surfer-rfid/PCB/README.md

# PCB
PCB schematics, layout, BOM, and other data required to generate the S.U.R.F.E.R. PCB.
Note that one will see "rfidr" in many places in the source code. This is short
for "RFID reader", before S.U.R.F.E.R. had a unique name.
