surfer-rfid/PCB/BOM/RFIDr_Open_BOM.xls

Id | Designator | Package | Unit Quantity | 5x Build Quantity | Ordering Quantity | Designation | Rating | Tolerance | Supplier | Supplier P/N (CT/BU) | Manufacturer | Manuf. P/N | Price 1x | PriceBulk | PriceBreak | ReplLevel | Description | Notes
1 | R95,R94,R72,R75,R90,R88,R86,R7,R8,R17,R20,R21,R27,R28,R29,R36,R41,R44,R45,R47,R50,R58,R64,R69,R70,R73,R76,R77,R80,R82 | R_0402 | 30 | 150 | 200 | 0 | 1/16W | Jumper | Digikey | RMCF0402ZT0R00CT-ND | Stackpole Electronics, Inc | RMCF0402ZT0R00 | 0.1 | 0.00132 | 10000 | 0 | RES SMD 0.0 OHM JUMPER 1/16W
2 | R65,R71,R57,R74 | R_0402 | 0 | 0 | 0 | DNI
3 | U45,U47 | SC-70-5 | 2 | 10 | 20 | SN74LV1T34 | N/A | N/A | Digikey | 296-37177-1-ND | Texas Instruments | SN74LV1T34DCKR | 0.48 | 0.15 | 1000 | 1 | IC BUFFER GATE SGL CMOS SC-70-5
4 | C130,C131,C101,C123,C122,C121,C120,C108,C119,C110,C109,C116,C117,C118,C1,C2,C3,C4,C7,C8,C9,C15,C16,C17,C19,C26,C27,C29,C31,C34,C36,C38,C39,C40,C41,C42,C46,C47,C49,C50,C62,C89,C90,C92,C103 | C_0402 | 47 | 235 | 300 | 100n | 10V | 10.00% | Digikey | 490-7998-1-ND | Murata Electronics N.A. | GCM155R71C104KA55J | 0.1 | 0.0082 | 10000 | 0 | CAP CER 0.1UF 16V 10% X7R 0402
5 | C134,C111,C95,C44,C48,C55,C56,C85,C91,C105 | C_0402 | 10 | 50 | 100 | 1u | 16V | 10.00% | Digikey | 445-13181-1-ND | Samsung Electro-Mechanics | CGB2A1X5R1C105K033BC | 0.1 | 0.03542 | 5000 | 0 | CAR CER 1UF 16V 10% X5R 0402
6 | C135,C69,C70,C73 | C_0402 | 4 | 20 | 100 | 10n | 25V | 10.00% | Digikey | 490-6341-1-ND | Murata Electronics N.A. | GRM155R71E103KA01J | 0.1 | 0.00275 | 10000 | 0 | CAP CER 10000PF 25V 10% X7R 0402
7 | C132,C51,C52,C133,C45,C43 | C_0805 | 6 | 30 | 100 | 4.7u | 16V | 10.00% | Digikey | 490-7215-1-ND | Murata Electronics N.A. | GRM21BR61C475KA88K | 0.22 | 0.024 | 10000 | 0 | CAP CER 4.7UF 16V 10% X5R 0805
8 | U44 | MBR0520LTR | 1 | 5 | 10 | MBR0520LTR | 20V | N/A | Digikey | MBR0520LCT-ND | ON Semiconductor | MBR0520L | 0.39 | 0.0766 | 1000 | 0 | DIODE SCHOTTKY 20V 500MA SOD123
9 | U43 | SOT-23-5 | 1 | 5 | 10 | LM2767M5 | N/A | N/A | Digikey | LM2767M5/NOPBCT-ND | Texas Instruments | LM2767M5/NOPB | 0.92 | 0.031 | 15000 | 0 | IC REG SWITCHD CAP 2VIN SOT23
10 | U46 | SOT-23-5 | 1 | 5 | 10 | LP3985IM5-5.0 | N/A | N/A | Digikey | LP3985IM5-5.0/NOPBCT-ND | Texas Instruments | LP3985IM5-5.0/NOPB | 0.66 | 0.23 | 5000 | 0 | IC REG LINEAR 5V 150MA SOT23-5
11 | U15,U17,U16 | SOT-89-5 | 3 | 15 | 30 | AP7361C-Y5-13 | N/A | N/A | Digikey | AP7361C-Y5-13DICT-ND | Diodes Incorporated | AP7361C-Y5-13 | 0.65 | 0.19 | 25000 | 1 | IC REG LINEAR POS ADJ 1A SOT89-5
12 | D3,D9,D10 | R_0402 | 3 | 15 | 100 | XGD10402KR | 24V | N/A | Digikey | F6924CT-ND | Littelfuse Inc. | XGD10402KR | 0.52 | 0.12284 | 5000 | 0 | TVS DIODE 24VWM 40VC 0402
13 | C129,C128 | C_0201 | 2 | 10 | 150 | 22p | 25V | 2.00% | Digikey | 712-1220-1-ND | Johanson Technology Inc. | 250R05L220GV4T | 0.26 | 0.048 | 5000 | 0 | CAP CER 22PF 25V C0G/NP0 0201
14 | C106 | C_0402 | 1 | 5 | 150 | 1.2p | 50V | 0.1pF | Digikey | 490-8085-1-ND | Murata Electronics N.A. | GJM1555C1H1R2BB01 | 0.17 | 0.029 | 5000 | 0 | CAP CER 1.2PF 50V C0G/NP0 0402
15 | C127, C67 | C_0402 | 0 | 0 |  | DNI |  |  |  |  |  |  |  |  |  |  |  | Double check on this one
16 | L5 | L_0402 | 1 | 5 | 150 | 12n | 250mA | 5.00% | Digikey | 712-1453-1-ND | Johanson Technology Inc. | L-07C12NJV6T | 0.1 | 0.01714 | 5000 | 1 | FIXED IND 12nH 250mA 500MOHM
17 | U23,U18,U19 | SMA_72970 | 0 | 0 | 0 | DNI | N/A | N/A | Digikey | 501-1381-ND | Pomona Electronics | 72970 | 5.79 | 4.98 | 100 | 1 | CONN SMA RCPT STR 50OHM EDGE MNT
18 | Q2 | SOT-323 | 1 | 5 | 10 | CTRL_NMOS | 100mA | N/A | Mouser | 757-SSM3K17SULF | Toshiba | SSM3K17SU,LF | 0.44 | 0.05 | 45000 | 0 | MOSFET 50V VDS 7V VGSS 100mA ID 150mW
19 | TP2,TP1 | TESTPOINT | 0 | 0 | 0 | TESTPOINT
20 | U42 | TSOT-23-5 | 0 | 0 | 0 | DNI
21 | R93,R92 | R_0201 | 2 | 10 | 150 | 10k | 1/20W | 5.00% | Digikey | RMCF0201JG10K0CT-ND | Stackpole Electronics, Inc | RMCF0201JG10K0 | 0.1 | 0.00276 | 5000 | 0 | RES SMD 10K OHM 5% 1/20W 0201
22 | R91,R89,R2,R3,R5,R9,R10,R11,R12,R18,R19,R30,R31,R32,R33,R34,R35,R68,R81 | R_0402 | 19 | 95 | 150 | 10k | 1/16W | 1.00% | Digikey | RMCF0402JT10K0CT-ND | Stackpole Electronics, Inc | RMCF0402JT10K0 | 0.1 | 0.00198 | 10000 | 0 | RES SMD 10K OHM 1% 1/16W 0402
23 | C22,C125,C28,C35,C37,C57,C58,C59,C63,C64,C71,C79,C80,C81,C82,C100,C107 | C_0402 | 17 | 85 | 150 | 100p | 50V | 5.00% | Digikey | 490-8180-1-ND | Murata Electronics N.A. | GRM1555C1H101FA01D | 0.1 | 0.01047 | 10000 | 0 | CAP CER 100PF 50V 5% C0G/NP0 0402
24 | U10 | EQFP-144_20x20mm_Pitch0.5mm | 1 | 5 | 10 | 10M02E144 | N/A | N/A | Digikey | 544-3098-ND | Altera | 10M02SCE144C8G | 7.38 | 5.54 | 500 | 2 | IC FPGA 101 I/O 144EQFP
25 | C124,C18,C24,C32,C53,C54,C65,C74,C76,C104 | C_1206 | 10 | 50 | 60 | 10u | 10V | 10.00% | Digikey | 587-1342-1-ND | Taiyo Yuden | LMK316BJ106KL-T | 0.23 | 0.0418 | 2000 | 0 | CAP CER 10UF 10V 10% X5R 1206
26 | FID1,FID2,FID3,FID4 | RFIDr_Fiducial_1mm_Dia_2.54mm_Outer_CopperTop | 0 | 0 | 0 | FIDUCIAL
27 | U7 | NX2520 | 1 | 5 | 10 | NX2520SA_16MHz_XTAL | 8pF | 15PPM | Digikey | 644-1169-1-ND | NDK | NX2520-16MHz-STD-CSW-5 | 1.14 | 0.66 | 3000 | 0 | Crystal 16.000MHz 15ppm 8pF 80 Ohm 4-SMD
28 | U1 | USB_Micro-B-Round-Pegs | 1 | 5 | 10 | USB_Micro_B | N/A | N/A | Digikey | 609-4618-1-ND | FCI | 10118194-0001LF | 0.46 | 0.2 | 1200 | 0 | CONN RECEP USB – MICRO B 5 POS SMD
29 | L12,L10 | L_0603 | 2 | 10 | 100 | 1.6n | 700mA | 0.2nH | Digikey | 732-1746-1-ND | Wurth Electronics Inc | 744761016C | 0.38 | 0.26 | 1000 | 1 | FIXED IND 1.6NH 700MA 30 MOHM
30 | L9,L11 | L_0603 | 2 | 10 | 100 | 3.6n | 850mA | 0.5nH | Digikey | 490-1159-1-ND | Murata Electronics N.A. | LQW18AN3N6D00D | 0.17 | 0.072 | 1000 | 1 | FIXED IND 3.6NH 850MA 59 MOHM
31 | R87,R51 | R_0805 | 2 | 10 | 100 | 0 | 1/8W | JUMPER | Digikey | RMCF0805ZT0R00CT-ND | Stackpole Electronics, Inc | RMCF0805ZT0R00 | 0.1 | 0.0019 | 5000 | 0 | RES SMD 0.0 OHM JUMPER 1/8W 0805
33 | U32,U30 | QFN-12-1EP_2x2mm_Pitch0.5mm_wvias | 2 | 10 | 15 | PE64102 | N/A | N/A | Digikey | 1046-1066-1-ND | Peregrine Semiconductor | PE64102MLAA-Z | 0.72 | 0.686 | 3000 | 2 | RF DTC 100MHZ-3GHZ 12QFN
34 | SW1,SW3 | FSMRA3JH | 2 | 10 | 10 | SW_RESET | N/A | N/A | Digikey | 450-1657-ND | TE Connectivity | 1825027-8 | 0.15 | 0.07 | 2000 | 0 | SWITCH TACTILE SPST-NO 0.05A 24V
35 | U31,U29 | QFN-10-1EP_2x2mm_Pitch0.5mm_wvias | 2 | 10 | 15 | PE64906 | N/A | N/A | Digikey | 1046-1079-1-ND | Peregrine Semiconductor | PE64906B-Z | 0.79 | 0.71 | 100 | 2 | RF DTC 100MHZ-3GHZ 10QFN
36 | U41 | 0917BL18B100E | 1 | 5 | 10 | 0917BL18B100E | N/A | N/A | Digikey | 712-1023-1-ND | Johanson Technology Inc. | 0900BL18B100E | 0.54 | 0.182 | 1000 | 2 | BALUN GSM/DCS/PCS/CDMA 900MHZ | Was 0917BL18B100E. Fixed only here in the layout.
37 | U40 | SC-70-5 | 1 | 5 | 10 | LP5951MF | N/A | N/A | Digikey | LP5951MG-1.8/NOPBCT-ND | Texas Instruments | LP5951MG-1.8/NOPB | 0.7 | 0.225 | 1000 | 1 | LIN VLTG REG POS FIXED 1.8V 150MA | Actually it's the MG version we are using
38 | U39 | SF2049E | 1 | 5 | 10 | SF2049E | N/A | N/A | Mouser | 719-SF2049E | Murata Electronics N.A. | SF2049E | 1.33 | 0.815 | 250 | 1 | FILTER SAW RF 915MHZ SM3030-6
39 | U36,U38,U35,U34,U37 | MountingHole_2.2mm | 0 | 0 | 0 | MountingHole
40 | U26 | CX3225 | 1 | 5 | 10 | CX3225GB_36MHz_XTAL | 18pF | 20PPM | Digikey | 1253-1218-1-ND | AVX/Kyocera Corp. | CX3225GB360000P0HPQCC | 0.77 | 0.445 | 1000 | 1 | 36MHZ 20PPM 18PF XTAL 4SMD NOLEAD
41 | U11 | TSSOP-8_4.4x3mm_Pitch0.65mm | 1 | 5 | 10 | TSV358 | N/A | N/A | Digikey | 497-10280-1-ND | STMicroelectronics | TSV358IYPT | 0.61 | 0.227 | 1000 | 0 | IC OPAMP GP 1.4MHZ RRO 8TSSOP
42 | U33 | PAT1220 | 1 | 5 | 50 | PAT1220 | N/A | N/A | Digikey | PAT126CT-ND | Susumu | PAT1220-C-6DB-T5 | 0.35 | 0.14885 | 1000 | 0 | RF ATTEN 6dB 0-10GHZ 100MW 0805 | Possibly replace with 6dB atten version during initial build
43 | R85,R39,R40,R15 | R_0402 | 4 | 20 | 150 | 470 | 1/16W | 1.00% | Digikey | RMCF0402FT470RCT-ND | Stackpole Electronics, Inc | RMCF0402FT470R | 0.1 | 0.00261 | 5000 | 0 | RES SMD 470 OHM 1% 1/16W 0402
44 | C5,C6,C10,C13,C68,C86,C93 | C_0402 | 7 | 35 | 150 | 12p | 50V | 5.00% | Digikey | 490-3115-1-ND | Murata Electronics N.A. | GJM1555C1H120FB01D | 0.1 | 0.01113 | 10000 | 0 | CAP CER 12PF 50V 1% NP0 0402
45 | C11 | C_0402 | 1 | 5 | 150 | 47n | 25V | 10.00% | Digikey | 490-3254-1-ND | Murata Electronics N.A. | GRM155R71E473KA88D | 0.1 | 0.0037 | 10000 | 0 | CAP CER 0.047UF 25V 10% X7R 0402
46 | C12,C23,C30,C33,C72,C75,C77,C78,C83,C102,C126 | C_0402 | 10 | 50 | 150 | 1n | 50V | 10.00% | Digikey | 490-6348-1-ND | Murata Electronics N.A. | GRM155R71H102JA01D | 0.1 | 0.00216 | 10000 | 0 | CAP CER 1000PF 50V 10% X7R 0402
47 | C14 | C_0402 | 1 | 5 | 150 | 2.2n | 50V | 10.00% | Digikey | 490-8257-1-ND | Murata Electronics N.A. | GRM155R61H222KA01D | 0.1 | 0.00275 | 10000 | 0 | CAP CER 2200PF 50V 10% X7R 0402
48 | C20 | C_0402 | 1 | 5 | 150 | 0.8p | 50V | 0.05pF | Mouser | 81-GRM1555C1HR80WA01D | Murata Electronics N.A. | GRM1555C1HR80WA01D | 0.17 | 0.0226 | 10000 | 0 | CAP CER 0.8PF 50V +/-0.05PF NP0 0402
49 | C21 | C_0402 | 1 | 5 | 150 | 1.5p | 50V | 0.1pF | Digikey | 490-8087-1-ND | Murata Electronics N.A. | GJM1555C1H1R5BB01 | 0.17 | 0.028 | 5000 | 0 | CAP CER 1.5PF 50V C0G/NP0 0402
50 | C25,C98 | C_0402 | 2 | 10 | 150 | 2.2p | 50V | 0.1pF | Digikey | 490-6227-1-ND | Murata Electronics N.A. | GRM1555C1H2R2BA01D | 0.1 | 0.00756 | 10000 | 0 | CAP CER 2.2PF 50V +/-0.1PF NP0 0402
51 | C60,C61 | C_0402 | 2 | 10 | 150 | 33p | 50V | 1.00% | Digikey | 490-16377-1-ND | Murata Electronics N.A. | GJM1555C1H330FB01D | 0.23 | 0.03 | 30000 | 0 | CAP CER 33PF 50V C0G/NP0 0402
52 | C66 | C_0402 | 1 | 5 | 150 | 6.8p | 50V | 0.1pF | Digikey | 490-6252-1-ND | Murata Electronics N.A. | GRM1555C1H6R8BA01D | 0.1 | 0.0055 | 5000 | 0 | CAP CER 6.8PF 50V NP0 0402
53 | C84,C87,C88,C96,C97 | C_0402 | 0 | 0 | 0 | DNP
54 | C94 | C_0402 | 1 | 5 | 150 | 4.7p | 50V | 0.25pF | Digikey | 490-5874-1-ND | Murata Electronics N.A. | GRM1555C1H4R7CA01D | 0.1 | 0.00368 | 10000 | 0 | CAP CER 4.7PF 50V NP0 0402
55 | C99 | C_0402 | 1 | 5 | 150 | 18p | 50V | 5.00% | Digikey | 490-14582-1-ND | Murata Electronics N.A. | GRM1555C1H180JA01J | 0.1 | 0.00221 | 10000 | 0 | CAP CER 18PF 50V C0G/NP0 0402
56 | C112,C114 | C_0402 | 2 | 10 | 150 | 5.2p | 50V | 0.1pF | Mouser | 81-GJM1555C1H5R2BB01D | Murata Electronics N.A. | GJM1555C1H5R2BB01D | 0.19 | 0.03467 | 5000 | 0 | CAP CER 5.2PF 50V C0G/NP0 0402
57 | C113 | C_0402 | 1 | 5 | 150 | 15p | 50V | 2.00% | Digikey | 712-1260-1-ND | Johanson Technology Inc. | 500R07S150GV4T | 0.36 | 0.086 | 5000 | 0 | CAP CER 15PF 50V C0G/NP0 0402
58 | C115 | C_0402 | 1 | 5 | 150 | 20p | 50V | 1.00% | Digikey | 490-11204-1-ND | Murata Electronics N.A. | GJM1555C1H200FB01D | 0.24 | 0.043 | 5000 | 0 | CAP CER 20PF 50V C0G/NP0 0402
59 | D1,D2,D6,D7 | LED_0603 | 4 | 20 | 50 | LED_BLU | 54mcd | 2V | Digikey | VLMS1300-GS08CT-ND | Vishay Semiconductor Opto. Division | VLMS1300-GS08 | 0.43 | 0.064 | 3000 | 0 | LED SUPER RED 0603 SMD
60 | D4,D8,D12 | LED_0603 | 3 | 15 | 50 | LED_GRN | 35mcd | 2V | Digikey | VLMO1300-GS08CT-ND | Vishay Semiconductor Opto. Division | VLMO1300-GS08 | 0.46 | 0.068 | 3000 | 0 | LED ORANGE 0603 SMD
61 | D5,D11 | LED_0603 | 2 | 10 | 50 | LED_YLW | 104mcd | 2.1V | Digikey | VLMY1300-GS08CT-ND | Vishay Semiconductor Opto. Division | VLMY1300-GS08 | 0.46 | 0.068 | 3000 | 0 | LED YELLOW 0603 SMD
63 | FB1,FB2,FB3,FB4,FB5 | L_0805 | 5 | 25 | 100 | FERRITE | 2A | N/A | Digikey | 490-1054-1-ND | Murata Electronics N.A. | BLM21PG221SN1D | 0.11 | 0.024 | 4000 | 1 | FERRITE CHIP 220 OHM 0805
64 | L1 | L_0402 | 1 | 5 | 150 | 10n | 100mA | 2.00% | Digikey | 490-6743-1-ND | Murata Electronics N.A. | LQP15MN10NG02D | 0.2 | 0.05936 | 10000 | 0 | FIXED IND 10NH 100MA 1.3 OHM SMD
65 | L2 | L_0402 | 1 | 5 | 150 | 4.7n | 160mA | 0.1nH | Digikey | 490-1132-1-ND | Murata Electronics N.A. | LQP15MN4N7B02D | 0.19 | 0.069 | 2500 | 0 | FIXED IND 4.7NH 160MA 600 MOHM
66 | L3 | L_0402 | 1 | 5 | 150 | 3.3n | 190mA | 0.1nH | Digikey | 490-1130-1-ND | Murata Electronics N.A. | LQP15MN3N3B02D | 0.18 | 0.05344 | 10000 | 0 | FIXED IND 3.3NH 190MA 400 MOHM
67 | L4 | L_0402 | 1 | 5 | 150 | 1n | 300mA | 0.3nH | Digikey | 712-1410-1-ND | Johanson Technology Inc. | L-07C1N0SV6T | 0.1 | 0.0153 | 10000 | 1 | FIXED IND 1NH 300MA 120 MOHM SMD
68 | L6 | L_0402 | 1 | 5 | 150 | 1.8n | 300mA | 0.3nH | Digikey | 712-1412-1-ND | Johanson Technology Inc. | L-07C1N8SV6T | 0.1 | 0.0153 | 10000 | 1 | FIXED IND 1.8NH 300MA 140 MOHM
69 | P1 | Pin_Header_Straight_1x04 | 1 | 5 | 10 | CONN_01X04 | N/A | N/A | Digikey | 952-2265-ND | Harwin Inc. | M20-9990445 | 0.14 | 0.06 | 10000 | 0 | 4 POS HDR 1 ROW UNSH BRKWY 100MIL
70 | P2 | Pin_Header_Straight_2x04 | 1 | 5 | 10 | CONN_02X04 | N/A | N/A | Digikey | 952-2122-ND | Harwin Inc. | M20-9980445 | 0.27 | 0.12 | 10000 | 0 | 8 POS HDR 2 ROW UNSH BRKWY 100MIL
71 | P3,P5 | Pin_Header_Straight_2x08 | 2 | 10 | 15 | CONN_02X08 | N/A | N/A | Digikey | 952-2553-ND | Harwin Inc. | M20-9980845 | 0.55 | 0.242 | 10000 | 0 | 16 POS HDR 2 ROW UNSH BRKWY 100MIL
72 | P4 | Pin_Header_Straight_2x05 | 1 | 5 | 10 | CONN_02X05 | N/A | N/A | Digikey | 952-2380-ND | Harwin Inc. | M20-9980545 | 0.34 | 0.147 | 10000 | 0 | 10 POS HDR 2 ROW UNSH BRKWY 100MIL
73 | Q1 | SOT23 | 1 | 5 | 10 | DMP2305 | 20V | N/A | Digikey | DMP2305UDICT-ND | Diodes Incorporated | DMP2305U-7 | 0.46 | 0.072 | 3000 | 1 | MOSFET P channel, Metal Oxide, 20V, 1.4W
74 | R1,R22,R37,R43,R59 | R_0402 | 5 | 25 |  | DNP
75 | R4,R6 | R_0402 | 2 | 10 | 150 | 2.2k | 1/16W | 1.00% | Digikey | 311-2.20KLRCT-ND | Stackpole Electronics, Inc | RC0402FR-072K2L | 0.1 | 0.00181 | 5000 | 0 | RES SMD 2.2K OHM 1% 1/16W 0402
76 | R13,R14,R52,R53,R55 | R_0402 | 5 | 25 | 150 | 220 | 1/16W | 1.00% | Digikey | 311-220LRCT-ND | Yageo | RC0402FR-07220RL | 0.1 | 0.00181 | 5000 | 0 | RES SMD 220 OHM 1% 1/16W 0402
77 | R16,R23,R25 | R_0402 | 3 | 15 | 150 | 12k | 1/16W | 1.00% | Digikey | RMCF0402FT12K1CT-ND | Stackpole Electronics, Inc | RMCF0402FT12K1 | 0.1 | 0.00198 | 10000 | 0 | RES SMD 12.1K OHM 1% 1/16W 0402
78 | R24,R26 | R_0402 | 2 | 10 | 150 | 100k | 1/16W | 1.00% | Digikey | RMCF0402FT100KCT-ND | Stackpole Electronics, Inc | RMCF0402FT100K | 0.1 | 0.00198 | 10000 | 0 | RES SMD 100K OHM 1% 1/16W 0402
79 | R38 | R_0402 | 1 | 5 | 150 | 1k | 1/16W | 1.00% | Digikey | RMCF0402FT1K00CT-ND | Stackpole Electronics, Inc | RMCF0402FT1K00 | 0.1 | 0.00198 | 10000 | 0 | RES SMD 1K OHM 1% 1/16W 0402
80 | R42 | R_0402 | 1 | 5 | 150 | 15k | 1/16W | 1.00% | Digikey | RMCF0402FT15K0CT-ND | Stackpole Electronics, Inc | RMCF0402FT15K0 | 0.1 | 0.00198 | 10000 | 0 | RES SMD 15K OHM 1% 1/16W 0402
81 | R46 | R_0402 | 1 | 5 | 150 | 1.13k | 1/16W | 1.00% | Digikey | RMCF0402FT1K13CT-ND | Stackpole Electronics, Inc | RMCF0402FT1K13 | 0.1 | 0.00198 | 10000 | 0 | RES SMD 1.13K OHM 1% 1/16W 0402
83 | R49 | R_0402 | 1 | 5 | 150 | 1.1k | 1/16W | 1.00% | Digikey | RMCF0402FT1K10CT-ND | Stackpole Electronics, Inc | RMCF0402FT1K10 | 0.1 | 0.00198 | 10000 | 0 | RES SMD 1.1K OHM 1% 1/16W 0402
84 | R54 | R_0402 | 1 | 5 | 150 | 82k | 1/16W | 1.00% | Digikey | RMCF0402FT82K0CT-ND | Stackpole Electronics, Inc | RMCF0402FT82K0 | 0.1 | 0.00184 | 5000 | 0 | RES SMD 82K OHM 1% 1/16W 0402
85 | R56 | R_0402 | 1 | 5 | 150 | 36k | 1/16W | 1.00% | Digikey | RMCF0402FT36K0CT-ND | Stackpole Electronics, Inc | RMCF0402FT36K0 | 0.1 | 0.00219 | 5000 | 0 | RES SMD 36K OHM 1% 1/16W 0402
86 | R60 | R_0402 | 1 | 5 | 150 | 68k | 1/16W | 1.00% | Digikey | RMCF0402FT68K1CT-ND | Stackpole Electronics, Inc | RMCF0402FT68K1 | 0.1 | 0.00198 | 10000 | 0 | RES SMD 68.1K OHM 1% 1/16W 0402
87 | R61,R78,R79 | R_0402 | 3 | 15 | 150 | 24k | 1/16W | 1.00% | Digikey | RMCF0402FT24K0CT-ND | Stackpole Electronics, Inc | RMCF0402FT24K0 | 0.1 | 0.00219 | 5000 | 0 | RES SMD 24K OHM 1% 1/16W 0402
88 | R62 | R_0402 | 1 | 5 | 150 | 23k | 1/16W | 1.00% | Digikey | RMCF0402FT23K2CT-ND | Stackpole Electronics, Inc | RMCF0402FT23K2 | 0.1 | 0.00219 | 5000 | 0 | RES SMD 23.2K OHM 1% 1/16W 0402
89 | R48, R63 | R_0402 | 2 | 10 | 150 | 47k | 1/16W | 1.00% | Digikey | RMCF0402FT47K0CT-ND | Stackpole Electronics, Inc | RMCF0402FT47K0 | 0.1 | 0.00198 | 10000 | 0 | RES SMD 47K OHM 1% 1/16W 0402
90 | R66,R67 | R_0402 | 2 | 10 | 150 | 50 | 1/16W | 1.00% | Digikey | RMCF0402FT49R9CT-ND | Stackpole Electronics, Inc | RMCF0402FT49R9 | 0.1 | 0.00198 | 10000 | 0 | RES SMD 49.9 OHM 1% 1/16W 0402
91 | R83 | R_0402 | 1 | 5 | 150 | 10 | 1/10W | 1.00% | Digikey | P10.0LCT-ND | Panasonic Electronic | ERJ-2RKF10R0X | 0.1 | 0.00365 | 5000 | 0 | RES SMD 10OHM 1% 1/10W 0402
92 | R84 | R_0402 | 1 | 5 | 150 | 19 | 1/10W | 1.00% | Digikey | P19.1LCT-ND | Panasonic Electronic | ERJ-2RKF19R1X | 0.1 | 0.003 | 5000 | 0 | RES SMD 19.1OHM 1% 1/10W 0402
93 | SW2,SW4 | FSMRA3JH | 2 | 10 | 10 | SW_SAMPLE | N/A | N/A | Digikey | 450-1657-ND | TE Connectivity | 1825027-8 | 0.15 | 0.07 | 2000 | 0 | SWITCH TACTILE SPST-NO 0.05A 24V
94 | U2 | SC-70-6 | 1 | 5 | 10 | PUSB2X4Y | N/A | N/A | Digikey | 568-12027-1-ND | NXP Semiconductors | PUSB2X4YH | 0.5 | 0.09234 | 3000 | 1 | TVS DIODE 3.8VC SC-88
95 | U3,U8,U9 | WQFN-10 | 3 | 15 | 20 | NLAS5223B | N/A | N/A | Mouser | 863-NLAS5223BLMNR2G | ON Semiconductor | NLAS5223BLMNR2G | 0.6 | 0.203 | 3000 | 1 | IC SWITCH DUAL SPDT 10WQFN
96 | U4 | FC-135 | 1 | 5 | 10 | FC-135_32p768_XTAL | 9pF | 20PPM | Digikey | SER4084CT-ND | EPSON | FC-135-32.7680KA-AC | 0.77 | 0.534 | 500 | 0 | CRYSTALS 32.768KHZ 9PF 20PPM
97 | U5 | SC-70-6 | 1 | 5 | 10 | DMN63D8LDW-7 | N/A | N/A | Digikey | DMN63D8LDW-7CT-ND | Diodes Incorporated | DMN63D8LDW-7 | 0.3 | 0.05883 | 1000 | 0 | MOSFET 2N-CH 30V 0.22A SOT363
98 | U6 | UQFN-48-1EP_6x6mm_Pitch0.4mm_wvias | 1 | 5 | 10 | NRF51822 | N/A | N/A | Digikey | 1490-1024-ND | Nordic Semiconductor ASA | NRF51822-QFAA-R7 | 4.62 | 2.04 | 10000 | 2 | IC RF BTLE 48VFQFN 256K FLASH 8K RAM
99 | U12 | JST-SM-02B-SRSS-TB | 1 | 5 | 10 | BatJSTCnctr | N/A | N/A | Digikey | 455-1802-1-ND | JST Sales America | SM02B-SRSS-TB(LF)(SN) | 0.49 | 0.23 | 1000 | 0 | CONN HEADER 2SH 2POS SIDE 1MM TIN
100 | U13 | THERMOCOUPLE | 0 | 0 |  | Thermocouple
101 | U14 | QFN-16-1EP_3x3mm_Pitch0.5mm_wvias | 1 | 5 | 10 | BQ24073 | N/A | N/A | Digikey | 296-23839-1-ND | Texas Instruments | BQ24073RGTT | 2.87 | 1.125 | 3000 | 2 | IC LI-ION CHARGE/PWR MGMT 16-QFN
102 | U20 | J0910CF15B0100 | 1 | 5 | 10 | J0910CF15B0100 | N/A | N/A | Digikey | 712-1534-1-ND | Johanson Technology Inc. | 0910CF15B0100E | 1.8 | 0.486 | 4000 | 1 | DIR COUPLER W/FILTER 910MHZ
103 | U21 | HHM22106 | 1 | 5 | 10 | HHM22106 | N/A | N/A | Digikey | 445-172642-1-ND | TDK Corporation | HHM22016C1 | 0.43 | 0.118 | 1000 | 1 | DIR CPLR 0.7-2.7GHz 28.5DB 0603
104 | U22 | SKY13350 | 1 | 5 | 10 | SKY13350 | N/A | N/A | Digikey | 863-1451-1-ND | Skyworks Solutions Inc. | SKY13350-385LF | 0.22 | 0.17125 | 3000 | 2 | IC SWITCH SPDT 6GHZ 6MLPD
105 | U24 | SC-70-5 | 1 | 5 | 10 | MAX2204 | N/A | N/A | Digikey | MAX2204EXK+TCT-ND | Maxim Integrated | MAX2204EXK+T | 1.16 | 0.7 | 500 | 1 | RF DET 0.45-2.5GHZ -16-5dBm
106 | U25 | SG210STF | 1 | 5 | 10 | SG210STF_XO | N/A | N/A | Digikey | SER3843-ND | EPSON | SG-210STF36.0000ML | 1.44 | 0.864 | 5000 | 2 | 36MHz CMOS XO 1.6-3.6V
107 | U27 | QFN-16-1EP_3x3mm_Pitch0.5mm_wvias | 1 | 5 | 10 | SKY65111 | N/A | N/A | Digikey | 863-1071-1-ND | Skyworks Solutions Inc. | SKY65111-348LF | 3.03 | 1.73 | 3000 | 2 | IC AMP 600-1100MHZ 12-QFN
108 | U28 | QFN-32-1EP_5x5mm_Pitch0.5mm_wvias | 1 | 5 | 10 | SX1257 | N/A | N/A | Digikey | SX1257IWLTRTCT-ND | Semtech Corporation | SX1257IWLTRT | 7.7 | 4.33 | 1000 | 2 | IC RX TXRX 32WFQFN
 |  | Copyright 2018 Superlative Semiconductor LLC
