surfer-rfid/PCB/RFIDr_Open_Top.kicad_pcb

## KiCad design RFIDr_Open_Top.kicad_pcb (2024-11-30)

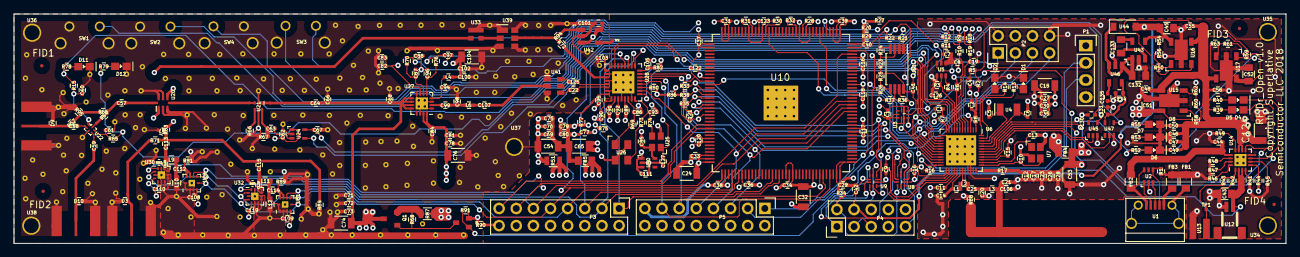
[picture p1: board RFIDr_Open_Top.kicad_pcb from above]

Board: 4 copper layers, 188.5 x 34.0 mm, 522 parts (0 on the bottom side), 190 nets.

Parts:
C1, C2, C3, C4, C7, C8, C9, C15, C16, C17, C19, C26, C27, C29, C31, C34, C36, C38, C39, C40, C41, C42, C46, C47, C49, C50, C62, C89, C90, C92, C101, C103, C108, C109, C110, C116, C117, C118, C119, C120, C121, C122, C123, C130, C131: 100n; C_0402
C5, C6, C10, C13, C68, C86, C93: 12p; C_0402
C11: 47n; C_0402
C12, C23, C30, C33, C72, C75, C77, C78, C83, C102, C126: 1n; C_0402
C14: 2.2n; C_0402
C18, C24, C32, C53, C54, C65, C74, C76, C104, C124: 10u; C_1206
C20: 0.8p; C_0402
C21: 1.5p; C_0402
C22, C28, C35, C37, C57, C58, C59, C63, C64, C71, C79, C80, C81, C82, C100, C107, C125: 100p; C_0402
C25, C98: 2.2p; C_0402
C43, C45, C51, C52, C132, C133: 4.7u; C_0805
C44, C48, C55, C56, C85, C91, C95, C105, C111, C134: 1u; C_0402
C60, C61: 33p; C_0402
C66: 6.8p; C_0402
C67, C127: DNI; C_0402
C69, C70, C73, C135: 10n; C_0402
C84, C87, C88, C96, C97: DNP; C_0402
C94: 4.7p; C_0402
C99: 18p; C_0402
C106: 1.2p; C_0402
C112, C114: 5.2p; C_0402
C113: 15p; C_0402
C115: 20p; C_0402
C128, C129: 22p; C_0201
D1, D2, D7: LED_BLU; LED_0603
D3, D9, D10: XGD10402KR; R_0402
D4, D8, D12: LED_GRN; LED_0603
D5, D11: LED_YLW; LED_0603
D6: LED_RED; LED_0603
FB1, FB2, FB3, FB4, FB5: FERRITE; L_0805
FID1, FID2, FID3, FID4: FIDUCIAL; RFIDr_Fiducial_1mm_Dia_2.54mm_Outer_CopperTop
L1: 10n; L_0402
L2: 4.7n; L_0402
L3: 3.3n; L_0402
L4: 1n; L_0402
L5: 12n; L_0402
L6: 1.8n; L_0402
L9, L11: 3.6n; L_0603
L10, L12: 1.6n; L_0603
P1: CONN_01X04; Pin_Header_Straight_1x04
P2: CONN_02X04; Pin_Header_Straight_2x04
P3, P5: CONN_02X08; Pin_Header_Straight_2x08
P4: CONN_02X05; Pin_Header_Straight_2x05
Q1: DMP2305; SOT23
Q2: CTRL_NMOS; SOT-323
R1, R22, R37, R43, R59: DNP; R_0402
R2, R3, R5, R9, R10, R11, R12, R18, R19, R30, R31, R32, R33, R34, R35, R68, R81, R89, R91: 10k; R_0402
R4, R6: 2.2k; R_0402
R7, R8, R17, R20, R21, R27, R28, R29, R36, R41, R44, R45, R47, R50, R58, R64, R69, R70, R72, R73, R75, R76, R77, R80, R82, R86, R88, R90, R94, R95: 0; R_0402
R13, R14, R52, R53, R55: 220; R_0402
R15, R39, R40, R85: 470; R_0402
R16, R23, R25: 12k; R_0402
R24, R26: 100k; R_0402
R38: 1k; R_0402
R42: 15k; R_0402
R46: 1.13k; R_0402
R48: 46.8k; R_0402
R49: 1.1k; R_0402
R51, R87: 0; R_0805
R54: 82k; R_0402
R56: 36k; R_0402
R57, R65, R71, R74: DNI; R_0402
R60: 68k; R_0402
R61, R78, R79: 24k; R_0402
R62: 23k; R_0402
R63: 47k; R_0402
R66, R67: 50; R_0402
R83: 10; R_0402
R84: 19; R_0402
R92, R93: 10k; R_0201
SW1, SW3: SW_RESET; FSMRA3JH
SW2, SW4: SW_SAMPLE; FSMRA3JH
TP1, TP2: TESTPOINT
U1: USB_Micro_B; USB_Micro-B-Round-Pegs
U2: PUSB2X4Y; SC-70-6
U3, U8, U9: NLAS5223B; WQFN-10
U4: FC-135_32p768_XTAL; FC-135
U5: DMN63D8LDW-7; SC-70-6
U6: NRF51822; UQFN-48-1EP_6x6mm_Pitch0.4mm_wvias
U7: NX2520SA_16MHz_XTAL; NX2520
U10: 10M02E144; EQFP-144_20x20mm_Pitch0.5mm
U11: TSV358; TSSOP-8_4.4x3mm_Pitch0.65mm
U12: BatJSTCnctr; JST-SM-02B-SRSS-TB
U13: Thermocouple; THERMOCOUPLE
U14: BQ24073; QFN-16-1EP_3x3mm_Pitch0.5mm_wvias
U15, U16, U17: AP7361C-Y5-13; SOT-89-5
U18, U19, U23: SMA_72970
U20: J0910CF15B0100
U21: HHM22106
U22: SKY13350
U24: MAX2204; SC-70-5
U25: SG210STF_XO; SG210STF
U26: CX3225GB_36MHz_XTAL; CX3225
U27: SKY65111; QFN-16-1EP_3x3mm_Pitch0.5mm_wvias
U28: SX1257; QFN-32-1EP_5x5mm_Pitch0.5mm_wvias
U29, U31: PE64906; QFN-10-1EP_2x2mm_Pitch0.5mm_wvias
U30, U32: PE64102; QFN-12-1EP_2x2mm_Pitch0.5mm_wvias
U33: PAT1220
U34, U35, U36, U37, U38: MountingHole; MountingHole_2.2mm
U39: SF2049E
U40: LP5951MF; SC-70-5
U41: 0917BL18B100E
U42: LTC5505-1; TSOT-23-5
U43: LM2767M5; SOT-23-5
U44: MBR0520LTR
U45, U47: SN74LV1T34; SC-70-5
U46: LP3985IM5-5.0; SOT-23-5
V6, V7, V8, V9, V10, V11, V12, V14, V15, V16, V18, V19, V25, V35, V54, V105, V107, V108, V109, V110, V112, V113, V114, V115, V116, V117, V118, V119, V120, V121, V122, V124, V125, V126, V127, V128, V129, V130, V131, V132, V134, V135, V136, V137, V138, V139, V140, V141, V142, V143, V144, V145, V146, V147, V148, V149, V150, V151, V152, V153, V154, V155, V156, V157, V158, V159, V160, V161, V162, V163, V164, V165, V166, V167, V168, V169, V170, V171, V172, V173, V174, V175, V176, V177, V178, V179, V180, V181, V182, V183, V184, V185, V186, V187, V188, V189, V190, V191, V193, V194, V195, V196, V197, V198, V199, V200, V201, V202, V204, V205, V206, V207, V208, V209, V210, V211, V212, V213, V214, V215, V216, V217, V218, V219, V220, V221, V222, V223, V224, V225, V226, V227, V228, V229, V230, V231, V232, V234, V235, V236, V237, V312, V313, V314, V315, V316, V317, V318, V319, V320, V321, V322, V323, V324, V325, V326, V327, V328, V329, V330, V331, V332, V333, V334, V335, V336, V337, V338, V339, V340, V341, V342, V343, V344, V345, V346, V347, V348, V349, V350, V351, V357, V366, V367, V368, V369, V370, V371, V372, V373, V374, V375, V376, V377, V378, V379, V380, V381, V382, V383, V384: RF_VIA

Connections:
+1V2: C52.2, R61.2, U17.5
+2V5: C42.2, C45.2, P4.4, R54.2, U16.5, U43.4, U44.2
+5V: C130.1, C131.2, C134.1, U45.5, U46.5, U47.5
/ANT0: R15.1, R78.1, U47.4
/ANT1: R79.1, R85.2, U45.4
/CHGB: D4.1, U6.43, U14.9
/CTRLR_CIPO: P3.1, U10.54, U28.18
/CTRLR_COPI_CAP0_RDIO: P3.3, U10.52, U28.19, U32.12
/CTRLR_COPI_CAP1: P3.11, U10.105, U31.7
/CTRLR_COPI_CAP2: P3.15, U10.25, U30.12
/CTRLR_COPI_CAP3: P3.13, U10.26, U29.7
/CTRLR_NPS_DTC: P3.7, U10.40, U29.6, U30.1, U31.6, U32.1
/CTRLR_NPS_RDIO: P3.5, U10.42, U28.20
/CTRLR_PCLK: P3.9, U10.90, U28.17, U29.5, U30.3, U31.5, U32.3
/DIO2: U6.14, U28.23
/DIO3: U6.10, U28.24
/EN_VDD_1P2: R52.2, R59.1, U6.44, U17.1
/EN_VDD_PA: Q1.1, Q2.3, R68.2
/FPGA_CLK_36_IN: P5.9, U10.91, U28.10
/FPGA_IN_I: P5.5, U10.89, U28.15
/FPGA_IN_Q: P5.7, U10.88, U28.14
/FPGA_OUT_I: P5.11, U10.67, U28.13
/FPGA_OUT_Q: P5.13, U10.69, U28.12
/OPA_SPDT1_CTL: U3.8, U6.11, U24.4
/PGOODB: D5.1, U6.42, U14.7
/RDIO_RST_P: U6.15, U28.9
/RFIDr_Open_DigBB/CYCLE: R9.2, R10.2, SW4.2
/RFIDr_Open_DigBB/FPGA_IRQ: P5.1, U6.21, U10.106
/RFIDr_Open_DigBB/FPGA_PRPHL_CIPO: P2.5, U6.18, U10.115
/RFIDr_Open_DigBB/FPGA_PRPHL_COPI: P2.7, U6.17, U10.130
/RFIDr_Open_DigBB/FPGA_PRPHL_NPS: P2.3, U6.19, U10.13
/RFIDr_Open_DigBB/FPGA_PRPHL_PCLK: P2.1, U6.20, U10.113
/RFIDr_Open_DigBB/FPGA_RST_N: U6.22, U10.19
/RFIDr_Open_DigBB/FPGA_TCK_MCU: U6.28, U9.10
/RFIDr_Open_DigBB/FPGA_TDI_MCU: U6.26, U8.10
/RFIDr_Open_DigBB/FPGA_TDO_MCU: U6.25, U8.2
/RFIDr_Open_DigBB/FPGA_TMS_MCU: U6.27, U9.2
/RFIDr_Open_DigBB/PWR_TOGL: R2.2, R5.2, SW1.1
/RFIDr_Open_DigBB/RESET: R11.1, R12.1, SW3.2
/RFIDr_Open_DigBB/RFIDr_Open_FPGA/CONFIG_SEL: R28.2, U10.120
/RFIDr_Open_DigBB/RFIDr_Open_FPGA/CONF_DONE: R31.2, U10.135
/RFIDr_Open_DigBB/RFIDr_Open_FPGA/FPGA_TCK: R38.1, U9.9, U10.16
/RFIDr_Open_DigBB/RFIDr_Open_FPGA/FPGA_TDI: R35.2, U8.9, U10.17
/RFIDr_Open_DigBB/RFIDr_Open_FPGA/FPGA_TDO: U8.3, U10.18
/RFIDr_Open_DigBB/RFIDr_Open_FPGA/FPGA_TMS: R33.2, U9.3, U10.15
/RFIDr_Open_DigBB/RFIDr_Open_FPGA/JTAG_SEL: P4.2, R34.2, U8.4, U8.8, U9.4, U9.8
/RFIDr_Open_DigBB/RFIDr_Open_FPGA/JTAG_TCK: P4.1, U9.7
/RFIDr_Open_DigBB/RFIDr_Open_FPGA/JTAG_TDI: P4.9, U8.7
/RFIDr_Open_DigBB/RFIDr_Open_FPGA/JTAG_TDO: P4.3, U8.5
/RFIDr_Open_DigBB/RFIDr_Open_FPGA/JTAG_TMS: P4.5, U9.5
/RFIDr_Open_DigBB/RFIDr_Open_FPGA/NCONFIG: R32.2, U10.122
/RFIDr_Open_DigBB/RFIDr_Open_FPGA/NSTATUS: R30.2, U10.131
/RFIDr_Open_DigBB/RFIDr_Open_MCU/ADC_IN: R4.1, R6.2, U6.7
/RFIDr_Open_DigBB/RFIDr_Open_MCU/ANT0_3V: U6.40, U47.2
/RFIDr_Open_DigBB/RFIDr_Open_MCU/ANT1B: L1.1, L2.1, U6.31
/RFIDr_Open_DigBB/RFIDr_Open_MCU/ANT1_3V: U6.41, U45.2
/RFIDr_Open_DigBB/RFIDr_Open_MCU/ANT2B: C25.1, L2.2, U6.32
/RFIDr_Open_DigBB/RFIDr_Open_MCU/BAT_LED0: R14.2, U6.48
/RFIDr_Open_DigBB/RFIDr_Open_MCU/BAT_LED1: R13.2, U6.47
/RFIDr_Open_DigBB/RFIDr_Open_MCU/BAT_SENSE: R3.2, U5.2, U6.8
/RFIDr_Open_DigBB/RFIDr_Open_MCU/BTLE_DECOUPLE1: C15.1, U6.39
/RFIDr_Open_DigBB/RFIDr_Open_MCU/BTLE_DECOUPLE2: C11.1, U6.29
/RFIDr_Open_DigBB/RFIDr_Open_MCU/BTLE_SWCLK: P1.3, R16.2, U6.24
/RFIDr_Open_DigBB/RFIDr_Open_MCU/BTLE_SWDIO: P1.2, U5.6, U6.23
/RFIDr_Open_DigBB/RFIDr_Open_MCU/CYCLE_F: C8.2, R10.1, U6.6
/RFIDr_Open_DigBB/RFIDr_Open_MCU/LPXC1_BT: C6.1, U4.2, U6.45
/RFIDr_Open_DigBB/RFIDr_Open_MCU/LPXC2_BT: C5.1, U4.1, U6.46
/RFIDr_Open_DigBB/RFIDr_Open_MCU/PWR_TOGL_F: C4.2, R5.1, U6.4
/RFIDr_Open_DigBB/RFIDr_Open_MCU/RESET_F: C7.2, R11.2, U5.5
/RFIDr_Open_DigBB/RFIDr_Open_MCU/RFIDr_Open_BTLE_ANT/ANT: C21.1, C106.1, L3.2, R88.1
/RFIDr_Open_DigBB/RFIDr_Open_MCU/RFIDr_Open_PA_BIAS_CTRL/DAC_OA0: R23.1, R24.1, U11.3
/RFIDr_Open_DigBB/RFIDr_Open_MCU/RFIDr_Open_PA_BIAS_CTRL/DAC_OA0_FB: R21.1, R22.1, U11.2
/RFIDr_Open_DigBB/RFIDr_Open_MCU/RFIDr_Open_PA_BIAS_CTRL/DAC_OA1: R25.1, R26.1, U11.5
/RFIDr_Open_DigBB/RFIDr_Open_MCU/RFIDr_Open_PA_BIAS_CTRL/DAC_OA1_FB: R36.1, R37.1, U11.6
/RFIDr_Open_DigBB/RFIDr_Open_MCU/RFIDr_Open_PA_BIAS_CTRL/VDD_OPA_PA: C41.1, R23.2, R25.2, U3.9, U11.8
/RFIDr_Open_DigBB/RFIDr_Open_MCU/SAMPLE_F: C19.2, R19.1, U6.5
/RFIDr_Open_DigBB/RFIDr_Open_MCU/VDD_PA_BTLE: C14.1, L1.2, U6.30
/RFIDr_Open_DigBB/RFIDr_Open_MCU/XC1_BT: C10.1, U6.37, U7.3
/RFIDr_Open_DigBB/RFIDr_Open_MCU/XC2_BT: C13.1, U6.38, U7.1
/RFIDr_Open_DigBB/SAMPLE: R18.2, R19.2, SW2.1
/RFIDr_Open_PMU/ID: R1.2, U1.4, U2.4
/RFIDr_Open_PMU/RFIDr_Open_LDOS_QPUMP/CP_M: C133.2, U43.3
/RFIDr_Open_PMU/RFIDr_Open_LDOS_QPUMP/CP_P: C133.1, U43.5
/RFIDr_Open_PMU/RFIDr_Open_LDOS_QPUMP/VFB_1P2: R61.1, R63.2, U17.3
/RFIDr_Open_PMU/RFIDr_Open_LDOS_QPUMP/VFB_2P5: R54.1, R56.2, U16.3
/RFIDr_Open_PMU/RFIDr_Open_LDOS_QPUMP/VFB_3V: R60.1, R62.2, U15.3
/RFIDr_Open_PMU/RFIDr_Open_PMU_CORE/CEB: R41.1, U14.4
/RFIDr_Open_PMU/RFIDr_Open_PMU_CORE/ILIM: R49.1, U14.12
/RFIDr_Open_PMU/RFIDr_Open_PMU_CORE/ISET: R46.1, U14.16
/RFIDr_Open_PMU/RFIDr_Open_PMU_CORE/TD: R47.1, U14.15
/RFIDr_Open_PMU/RFIDr_Open_PMU_CORE/THERMOCOUPLE: R43.1, TP1.1, U13.1
/RFIDr_Open_PMU/RFIDr_Open_PMU_CORE/TMR: R48.1, U14.14
/RFIDr_Open_PMU/RFIDr_Open_PMU_CORE/TS: R42.2, R43.2, U14.1
/RFIDr_Open_PMU/USB_DM: U1.2, U2.1
/RFIDr_Open_PMU/USB_DP: U1.3, U2.3
/RFIDr_Open_PMU/USB_VBUS: C44.2, FB2.2, U14.13
/RFIDr_Open_PMU/USB_VBUS_PRE: FB2.1, U1.1, U2.6
/RFIDr_Open_Radio/RFIDr_Open_ANT_ACCESS/RX_ANT: U20.1, U33.2
/RFIDr_Open_Radio/RFIDr_Open_ANT_ACCESS/RX_ATT: U33.1, U39.2
/RFIDr_Open_Radio/RFIDr_Open_ANT_ACCESS/RX_FILT: R72.2, R94.1, U39.5
/RFIDr_Open_Radio/RFIDr_Open_ANT_ACCESS/TX_ANT: C57.1, U20.8
/RFIDr_Open_Radio/RFIDr_Open_PA/PA_FILT_OUT: C64.1, U21.1
/RFIDr_Open_Radio/RFIDr_Open_PA/PA_IN: C107.2, L6.1
/RFIDr_Open_Radio/RFIDr_Open_PA/PA_OUT: U20.4, U21.3
/RFIDr_Open_Radio/RFIDr_Open_TRX/RF2: C107.1, U41.2
/RFIDr_Open_Radio/RFIDr_Open_TRX/RF_ON: C125.2, U28.29
/RFIDr_Open_Radio/RFIDr_Open_TRX/RF_OP: C22.2, U28.30
/RFIDr_Open_Radio/RFIDr_Open_TRX/V1P8: C85.2, U25.4, U40.5
/RFIDr_Open_Radio/TERM: R83.2, U20.5
/RFPA_VCA: C88.1, R21.2, R70.1, U11.1
/RFPA_VCB: C97.1, R36.2, R76.1, U11.7
/RSSI_DET: C67.2, C126.2, P5.3, U6.9, U24.5
/VBAT: C43.2, R6.1, U12.1, U14.2, U14.3
/XO_ENABLE: C127.2, U6.16, U25.1
GND: C1.1, C2.1, C3.1, C4.1, C5.2, C6.2, C7.1, C8.1, C9.2, C10.2, C11.2, C12.2, C13.2, C14.2, C15.2, C16.2, C17.2, C18.2, C19.1, C20.2, C21.2, C23.2, C24.2, C26.2, C27.2, C28.2, C29.2, C30.2, C31.2, C32.2, C33.2, C34.2, C35.2, C36.2, C37.2, C38.2, C39.2, C40.2, C41.2, C42.1, C43.1, C44.1, C45.1, C46.1, C47.1, C48.2, C49.1, C50.1, C51.1, C52.1, C53.2, C55.2, C56.2, C106.2, C116.2, C117.2, C118.2, C120.2, C121.2, C122.2, C123.2, C124.2, C126.1, C130.2, C131.1, C132.1, C134.2, C135.2, D1.1, D2.1, D6.1, D7.1, D8.1, FB1.1, FB3.1, P1.4, P2.2, P2.4, P2.6, P2.8, P3.2, P3.4, P3.6, P3.8, P3.10, P3.12, P3.14, P3.16, P4.10, P5.2, P5.4, P5.6, P5.8, P5.10, P5.12, P5.14, P5.16, R1.1, R3.1, R12.2, R16.1, R22.2, R24.2, R26.2, R28.1, R37.2, R38.2, R41.2, R42.1, R45.2, R46.2, R47.2, R48.2, R49.2, R51.2, R53.2, R56.1, R62.1, R63.1, R86.2, R88.2, R90.2, U2.2, U3.4, U3.5, U3.6, U3.7, U5.1, U5.4, U6.13, U6.33, U6.34, U6.49, U7.2, U7.4, U8.6, U9.6, U10.11, U10.20, U10.30, U10.38, U10.45, U10.57, U10.66, U10.83, U10.96, U10.104, U10.110, U10.119, U10.133, U10.143, U10.145, U11.4, U12.2, U13.2, U14.8, U14.17, U15.2, U16.2, U17.2, U34.1, U35.1, U43.2, U45.3, U46.2, U47.3
GNDA: C54.2, C60.2, C61.1, C62.2, C65.2, C66.1, C67.1, C68.1, C69.2, C70.2, C71.1, C72.1, C73.1, C74.1, C75.2, C76.2, C77.2, C78.2, C79.2, C80.2, C81.2, C82.1, C83.1, C84.2, C85.1, C86.1, C87.2, C88.2, C89.2, C90.2, C91.1, C92.2, C93.1, C94.2, C95.2, C96.2, C97.2, C98.1, C100.2, C101.2, C102.2, C103.2, C104.2, C105.1, C108.2, C109.2, C110.2, C111.2, C119.2, C127.1, D3.2, D9.1, D10.2, D11.1, D12.1, L5.2, L10.2, L12.2, Q2.2, R51.1, R66.1, R67.1, R80.1, R81.1, R84.2, R86.1, R89.1, R90.1, R91.1, R92.2, R93.2, R95.2, SW1.2, SW1.3, SW2.2, SW2.3, SW3.3, SW4.1, SW4.3, U18.0, U18.2, U18.3, U18.4, U19.0, U19.2, U19.3, U19.4, U20.2, U20.3, U20.6, U20.7, U21.2, U21.5, U22.3, U23.0, U23.2, U23.3, U23.4, U24.2, U25.2, U26.2, U26.4, U27.1, U27.3, U27.8, U27.14, U27.17, U28.4, U28.7, U28.26, U28.28, U28.31, U28.33, U29.1, U29.2, U29.3, U29.10, U29.11, U30.2, U30.5, U30.6, U30.7, U30.8, U30.11, U30.13, U31.1, U31.2, U31.3, U31.10, U31.11, U32.2, U32.5, U32.6, U32.7, U32.8, U32.11, U32.13, U33.3, U36.1, U37.1, U38.1, U39.1, U39.3, U39.4, U39.6, U40.2, U41.1, U41.3, U42.2, V6.1, V7.1, V8.1, V9.1, V10.1, V11.1, V12.1, V14.1, V15.1, V16.1, V18.1, V19.1, V25.1, V35.1, V54.1, V105.1, V107.1, V108.1, V109.1, V110.1, V112.1, V113.1, V114.1, V115.1, V116.1, V117.1, V118.1, V119.1, V120.1, V121.1, V122.1, V124.1, V125.1, V126.1, V127.1, V128.1, V129.1, V130.1, V131.1, V132.1, V134.1, V135.1, V136.1, V137.1, V138.1, V139.1, V140.1, V141.1, V142.1, V143.1, V144.1, V145.1, V146.1, V147.1, V148.1, V149.1, V150.1, V151.1, V152.1, V153.1, V154.1, V155.1, V156.1, V157.1, V158.1, V159.1, V160.1, V161.1, V162.1, V163.1, V164.1, V165.1, V166.1, V167.1, V168.1, V169.1, V170.1, V171.1, V172.1, V173.1, V174.1, V175.1, V176.1, V177.1, V178.1, V179.1, V180.1, V181.1, V182.1, V183.1, V184.1, V185.1, V186.1, V187.1, V188.1, V189.1, V190.1, V191.1, V193.1, V194.1, V195.1, V196.1, V197.1, V198.1, V199.1, V200.1, V201.1, V202.1, V204.1, V205.1, V206.1, V207.1, V208.1, V209.1, V210.1, V211.1, V212.1, V213.1, V214.1, V215.1, V216.1, V217.1, V218.1, V219.1, V220.1, V221.1, V222.1, V223.1, V224.1, V225.1, V226.1, V227.1, V228.1, V229.1, V230.1, V231.1, V232.1, V234.1, V235.1, V236.1, V237.1, V312.1, V313.1, V314.1, V315.1, V316.1, V317.1, V318.1, V319.1, V320.1, V321.1, V322.1, V323.1, V324.1, V325.1, V326.1, V327.1, V328.1, V329.1, V330.1, V331.1, V332.1, V333.1, V334.1, V335.1, V336.1, V337.1, V338.1, V339.1, V340.1, V341.1, V342.1, V343.1, V344.1, V345.1, V346.1, V347.1, V348.1, V349.1, V350.1, V351.1, V357.1, V366.1, V367.1, V368.1, V369.1, V370.1, V371.1, V372.1, V373.1, V374.1, V375.1, V376.1, V377.1, V378.1, V379.1, V380.1, V381.1, V382.1, V383.1, V384.1
unnamed: C20.1, C25.2, L3.1
unnamed: C22.1, U41.4
unnamed: C57.2, R64.2, R65.1
unnamed: C58.1, U22.2
unnamed: C58.2, D9.2, R57.1, U18.1
unnamed: C59.1, U22.4
unnamed: C59.2, D10.1, U19.1
unnamed: C60.1, R15.2, U22.1
unnamed: C61.2, R85.1, U22.5
unnamed: C63.1, R67.2, U21.6
unnamed: C63.2, U24.3
unnamed: C86.2, R69.2, U28.6
unnamed: C87.1, R70.2, U27.6
unnamed: C89.1, U28.5
unnamed: C90.1, U28.1
unnamed: C91.2, R75.2, U28.2
unnamed: C92.1, U28.3
unnamed: C93.2, R73.2, R74.2, U28.8
unnamed: C94.1, L4.2, U27.4
unnamed: C95.1, R77.1, U28.32
unnamed: C96.1, R76.2, U27.5
unnamed: C98.2, C99.2, L6.2
unnamed: C99.1, U27.2
unnamed: C103.1, U28.25
unnamed: C105.2, R82.1, U28.16
unnamed: C112.1, L9.2, L10.1
unnamed: C112.2, R81.2, U29.8, U29.9
unnamed: C113.1, C115.1, L5.1, R71.1, R83.1, R84.1
unnamed: C113.2, C128.1, L9.1
unnamed: C114.1, L11.2, L12.1
unnamed: C114.2, R89.2, U31.8, U31.9
unnamed: C115.2, C129.1, L11.1
unnamed: C125.1, U41.6
unnamed: C128.2, R92.1, U30.9, U30.10
unnamed: C129.2, R93.1, U32.9, U32.10
unnamed: C132.2, U43.1, U44.1, U46.1, U46.3
unnamed: C135.1, U46.4
unnamed: D1.2, R13.1
unnamed: D2.2, R14.1
unnamed: D3.1, R71.2, U23.1
unnamed: D4.2, R39.1
unnamed: D5.2, R40.1
unnamed: D6.2, R52.1
unnamed: D7.2, R53.1
unnamed: D8.2, R55.1
unnamed: D11.2, R78.2
unnamed: D12.2, R79.2
unnamed: FB1.2, U1.6
unnamed: FB3.2, U1.5
unnamed: Q1.2, R68.1, R87.2
unnamed: Q2.1, R91.2, U6.3
unnamed: R4.2, U5.3
unnamed: R7.1, U6.12
unnamed: R8.2, U6.1
unnamed: R17.1, U6.35, U6.36
unnamed: R44.1, U14.5
unnamed: R45.1, U14.6
unnamed: R50.1, U16.1
unnamed: R57.2, R65.2, R95.1
unnamed: R58.1, U15.1
unnamed: R64.1, U22.6
unnamed: R66.2, U21.4
unnamed: R69.1, U26.1
unnamed: R72.1, U28.27
unnamed: R73.1, U26.3
unnamed: R74.1, U25.3
unnamed: R80.2, U28.11
unnamed: R94.2, U42.1
unnamed: TP2.1, U42.4
VAA: C54.1, C62.1, C65.1, C69.1, C70.1, C75.1, C77.1, C79.1, C80.1, C101.1, C108.1, C109.1, C110.1, C111.1, C119.1, FB5.2, R75.1, R77.2, R82.2, U24.1, U29.4, U30.4, U31.4, U32.4, U40.1, U40.3, U42.3, U42.5
VCC: C46.2, C47.2, C48.1, C49.2, C50.2, C55.1, C56.1, C124.1, R39.2, R40.2, R44.2, R50.2, R58.2, R59.2, R87.1, U14.10, U14.11, U15.4, U16.4, U17.4
VDD: C1.2, C2.2, C3.2, C9.1, C16.1, C18.1, C24.1, C27.1, C29.1, C30.1, C31.1, C32.1, C33.1, C34.1, C35.1, C36.1, C37.1, C38.1, C39.1, C40.1, C51.2, C116.1, C117.1, C118.1, C120.1, C121.1, C122.1, C123.1, FB4.1, FB5.1, P1.1, P5.15, R2.1, R7.2, R8.1, R9.1, R18.1, R20.1, R27.2, R29.1, R29.2, R30.1, R31.1, R32.1, R33.1, R34.1, R35.1, R55.2, R60.2, SW3.1, U3.1, U3.2, U3.10, U8.1, U9.1, U10.1, U10.2, U10.12, U10.22, U10.29, U10.34, U10.35, U10.36, U10.37, U10.43, U10.56, U10.58, U10.64, U10.71, U10.72, U10.73, U10.82, U10.93, U10.102, U10.107, U10.108, U10.109, U10.111, U10.118, U10.121, U10.132, U10.136, U10.142, U10.144, U15.5
VPP: C64.2, C66.2, C68.2, C71.2, C72.2, C73.2, C74.2, C76.1, C78.1, C81.1, C82.2, C83.2, C84.1, C100.1, C102.1, C104.1, L4.1, Q1.3, U27.7, U27.9, U27.10, U27.11, U27.12, U27.15, U27.16
VSS: C12.1, C17.1, C23.1, C26.1, C28.1, C53.1, FB4.2, R17.2
