surfer-rfid/PCB/CHANGES.txt

Copyright Superlative Semiconductor LLC 2021
This source describes Open Hardware and is licensed under the CERN-OHL-P v2
You may redistribute and modify this documentation and make products
using it under the terms of the CERN-OHL-P v2 (https:/cern.ch/cern-ohl).
This documentation is distributed WITHOUT ANY EXPRESS OR IMPLIED
WARRANTY, INCLUDING OF MERCHANTABILITY, SATISFACTORY QUALITY
AND FITNESS FOR A PARTICULAR PURPOSE. Please see the CERN-OHL-P v2
for applicable conditions.

01-07-2021: 
Author: E. Keehr (Superlative Semiconductor LLC)
Changes: Initial Open Source Release

04-08-2024:
Author: E. Keehr (Superlative Semiconductor LLC)
Changes: DNI C67 and add notes regarding the use of the RF PA output power sensor.

11-29-2024:
Author: E. Keehr (Superlative Semiconductor LLC)
Changes: Change value of C126 to 1nF in schematic (it was already 1nF in the BOM).
