surfer-rfid/PCB/(commit log)

2021-01-26 Push Kicad files to repo for first time.
    Push kicad files to repo for first time.
    [RFIDr_Open_ANT_ACCESS.sch, RFIDr_Open_BOM.xls, RFIDr_Open_BTLE_ANT.sch, RFIDr_Open_DigBB.sch, RFIDr_Open_FPGA.sch, RFIDr_Open_FPGA_CORE.sch, RFIDr_Open_JTAG_MUX.sch, RFIDr_Open_LDOS_QPUMP.sch]
2021-01-27 Update RFIDr_Open_BOM.xls
    Fixed BOM - somehow designators had been cut off. Also, hand-edited the changes required to get the transmit I/Q DAC offset calibration working.
    [RFIDr_Open_BOM.xls]
2021-01-30 Add missing footprint, fp-lib-table.
    Add some files to the main PCB repo.
2024-04-08 DNI C67 In Schematics and Layout
    C67 was DNIed in the BOM but not in the schematics/layout. C67 needs to be DNI or a small value for the SX1257 DAC autocalibration procedure to work. We DNIed C67 in both the schematic and layout to eliminate confusion.
    [RFIDr_Open_PA.sch, RFIDr_Open_Top.kicad_pcb]
2024-11-30 Change value of C126 to 1nF.
    In order for the DAC autocalibration routine to work, C67 needs to be DNI and C126 needs to be 1nF. Previously this had been changed in the BOM but not in the schematic or PCB. We fix this here.
    [RFIDr_Open_BOM.xls, RFIDr_Open_MCU.sch, RFIDr_Open_Top.kicad_pcb]
