surfer-rfid/PCB/(notices)

Notices in the files:
RFIDr_Open_Top.sch:
Copyright 2021 Superlative Semiconductor LLC.
Licensed under CERN-OHL-P v2 or later.
